W3AXL/MiniRIB-USB/README.md

# MiniRIB-USB
USB-based Motorola RIB

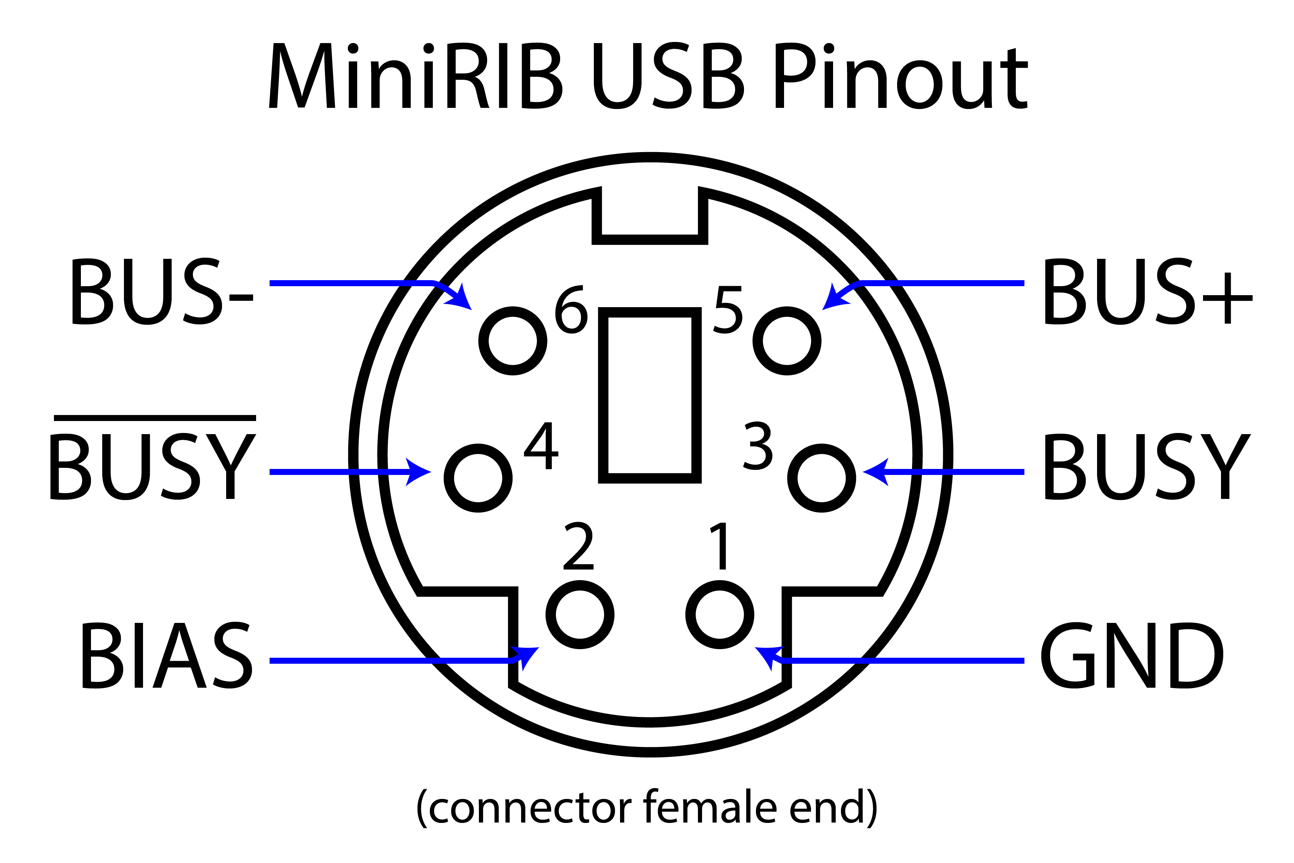
[picture p1: pinout.jpg]
pinout
