W3AXL/MiniRIB-USB/Full Assembly.step

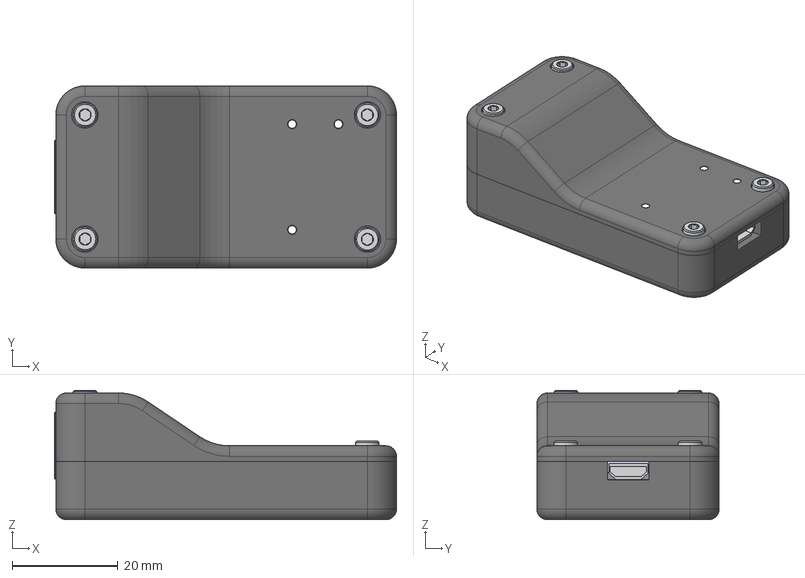
[picture p2: CAD file, 2023-05-07]
Full Assembly.step
64.8 x 34.5 x 24.5 mm
minirib-usb PCB
U254-051N-4BH83-F1B
91828A113_18-8 Stainless Steel Hex Nut x 4
Dialight 5151016F Light Pipe x 3
Case Top
91292A016_18-8 Stainless Steel Socket Head Screw x 2
91292A312_18-8 Stainless Steel Socket Head Screw x 2
Case Bottom
