W3AXL/MiniRIB-USB/minirib-usb-revE.step

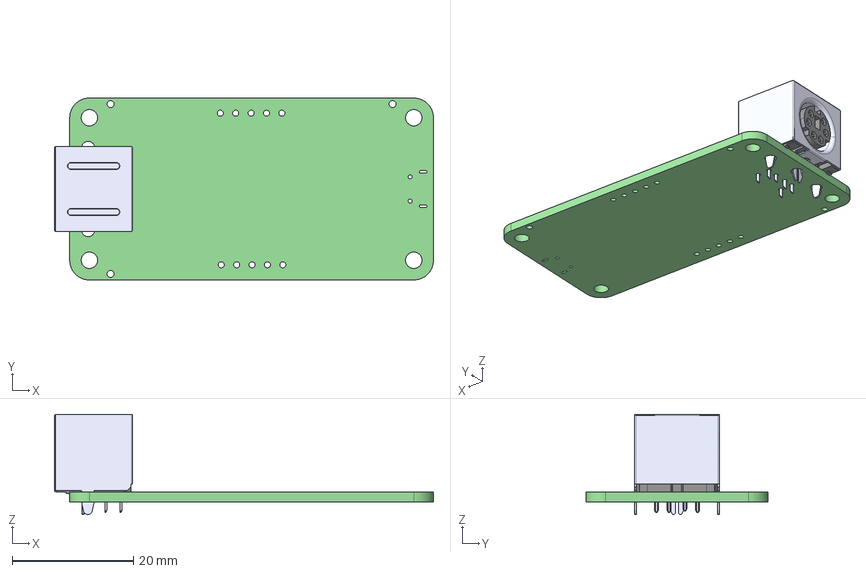
[picture p3: CAD file, 2023-05-07]
minirib-usb-revE.step
62.5 x 30.0 x 16.5 mm
minirib-usb PCB
