W3AXL/MiniRIB-USB/KMDGX-6S-BS_rC6.STEP

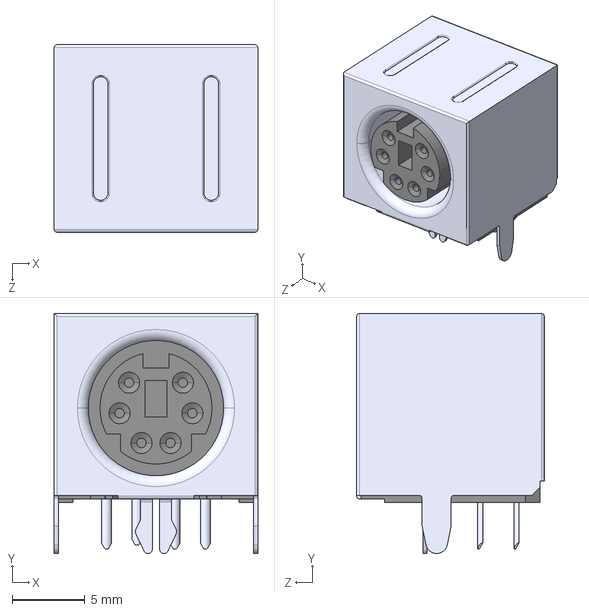
[picture p4: CAD file, 2021-12-10]
KMDGX-6S-BS_rC6.STEP
14.0 x 16.5 x 12.9 mm
