W3AXL/MiniRIB-USB/629105150521_Download_STP_629105150521_rev1.stp

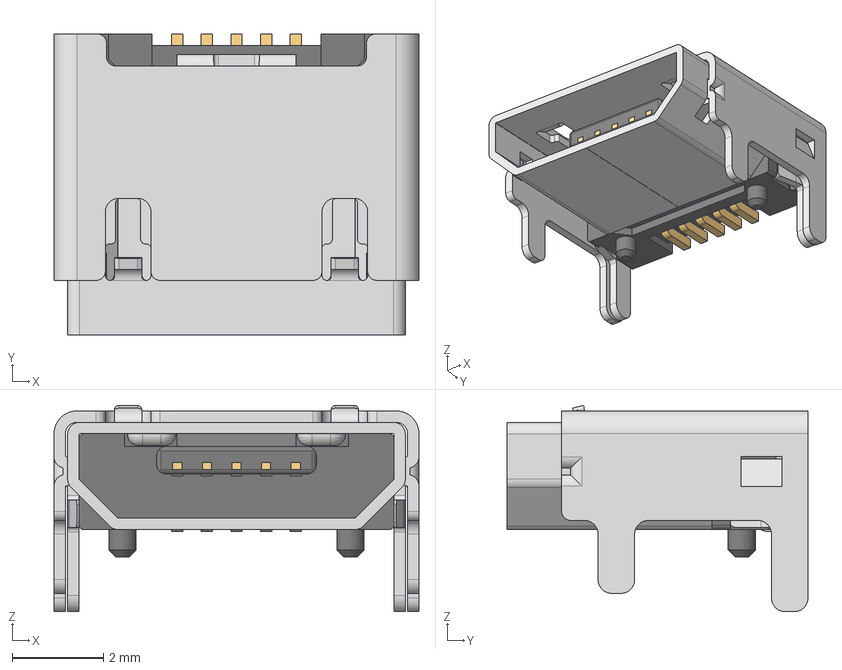
[picture p5: CAD file, 2021-12-10]
629105150521_Download_STP_629105150521_rev1.stp
8.00 x 6.60 x 4.52 mm
629105150521_Pin1 x 4
629105150521_Housing
629105150521_Pin2
629105150521_Shielding
629105150521_Shielding2
