W3AXL/MiniRIB-USB/sch/minirib-usb-revE.pdf

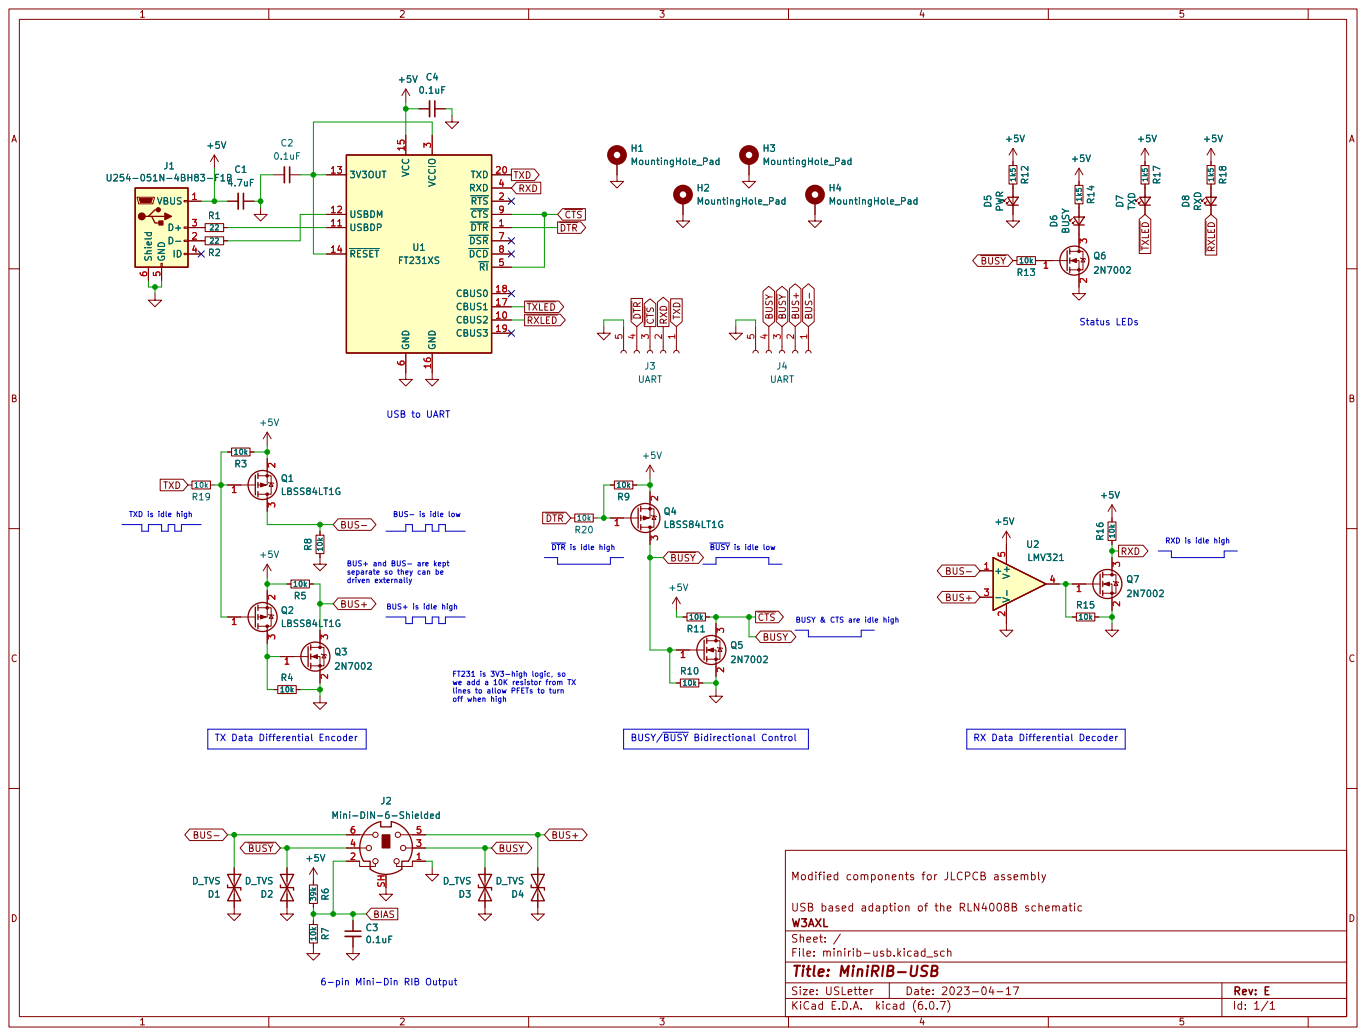
[picture p6: page 1]

RXD is idle high Status LEDs

~{BUSY} is idle low

FT231 is 3V3-high logic, so we add a 10K resistor from TX

Modified components for JLCPCB assembly

File: minirib-usb.kicad_sch Sheet: / W3AXL USB based adaption of the RLN4008B schematic

Id: 1/1 Title: MiniRIB-USB
