W3AXL/MiniRIB-USB/sch/minirib-usb-revD.pdf

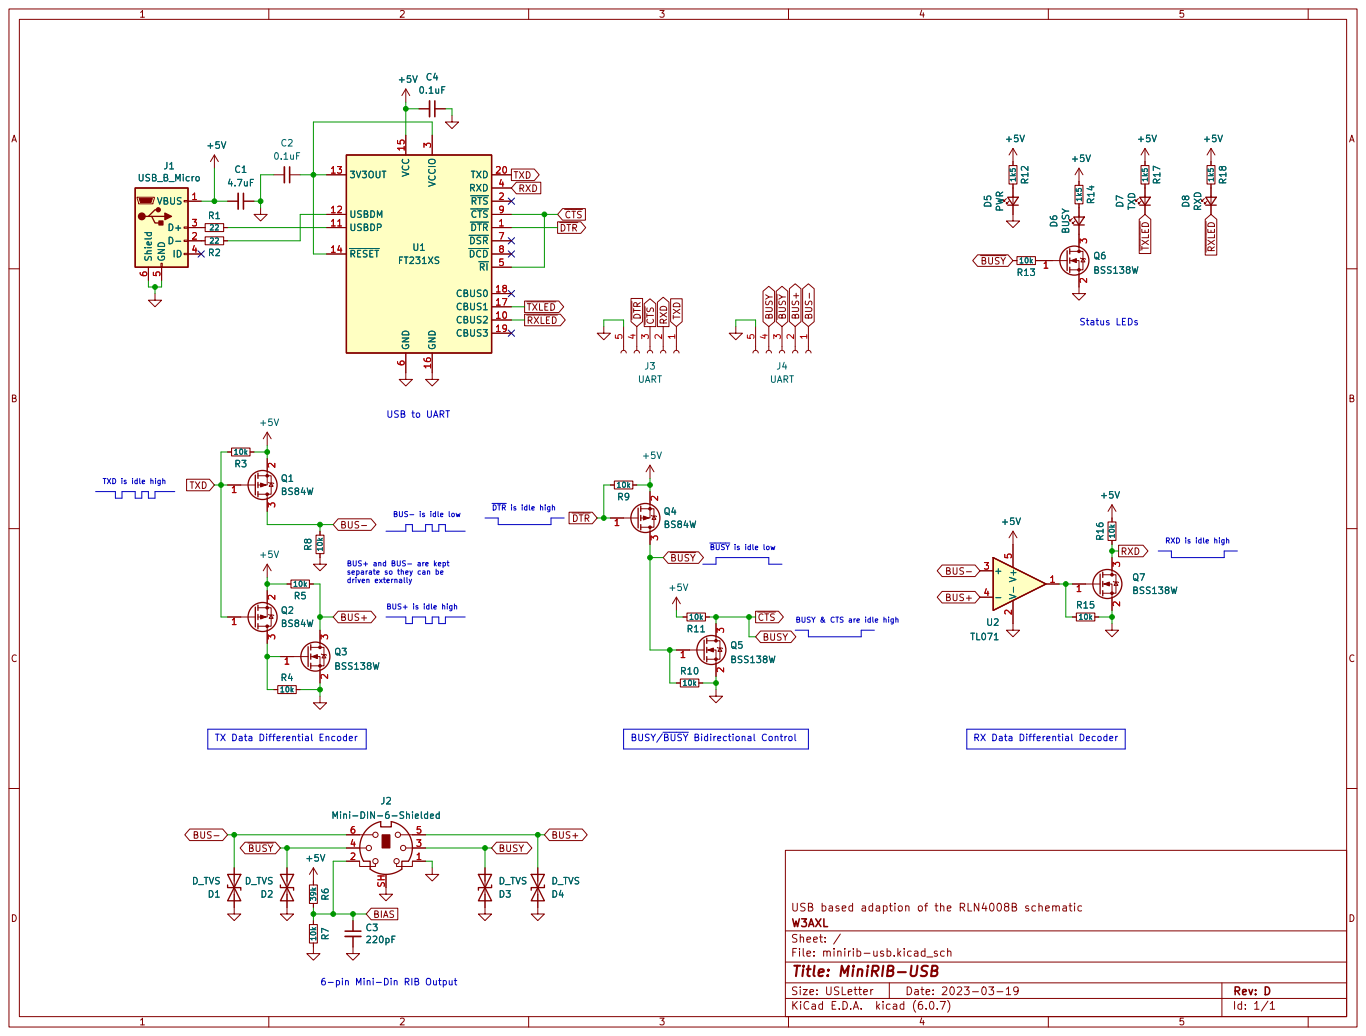
[picture p7: page 1]

2 3 Q7BSS138W R16 10k +5V ~{BUSY} BIAS BUS+ BUS-

Id: 1/1 Title: MiniRIB-USB
