W3AXL/MiniRIB-USB/sim/mosfet-datalines.asc

M1: pmos; BSS84
M2: pmos; BSS84
M3: nmos; 2N7002
M4: nmos; 2N7002
M5: pmos; BSS84
M6: nmos; 2N7002
M7: pmos; BSS84
M8: nmos; 2N7002
M9: nmos; 2N7002
M10: pmos; BSS84
R1: res; 10k
R2: res; 10k
R3: res; 10k
R4: res; 10k
R5: res; 10k
R6: res; 10k
R7: res; 10k
R8: res; 10k
R9: res; 10k
R10: res; 10k
R11: res; 10k
R12: res; 10k
R13: res; 10k
R14: res; 10k
R15: res; 10k
U1: UniversalOpamp2; Avol=100k GBW=1Meg Slew=1Meg; Ilimit=25m Rail=0 Vos=1m
V1: voltage; 5
V2: voltage; PULSE(3.3 0 100u 1u 1u 50u 100u 8)
V3: voltage; PULSE(5 0 1100u 1u 1u 50u 100u 8)
V4: voltage; PULSE(3.3 0 75u 1u 1u 850u 1000u 1)
V5: voltage; PULSE(0 5 1075u 1u 1u 850u 1000u 1)
Named nets: 0, 5V, TXD1, BUS-, BUS+, RXD, DATA2, DTR1, /BUSY2, /BUSY, CTS, BUSY, /DATA2, BUSY2
.tran 2m
