W3AXL/MiniRIB-USB/sim/rx-sim.asc

Q1: npn; 2N3904
Q2: pnp
R1: res; 20k
R2: res; 9k
R3: res; 1.5k
R4: res; 9k
U1: ADTL082
V1: voltage; 5
V2: voltage; PULSE(5 0 0.001 0 0 0.001 0.002)
V3: voltage; PULSE(0 5 0.001 0 0 0.001 0.002)
V4: voltage; 8
V5: voltage; -8
Named nets: 0, 5V, BUS-, BUS+, RXD, 8V, -8V
.tran 0.01
