W3AXL/MiniRIB-USB/sim/busy.asc

Q1: pnp; 2N3906
Q2: npn; 2N3904
R1: res; 4.7k
R2: res; 4.7k
R3: res; 4.7k
V1: voltage; 5
V2: voltage; PULSE(5 0 4u 0 0 4u 8u)
Named nets: 0, 5V, /BUSY, /DTR, /CTS, BUSY
.tran 50u
