W3AXL/MiniRIB-USB/minirib-usb.kicad_pcb

## KiCad design minirib-usb.kicad_pcb (2023-05-07)

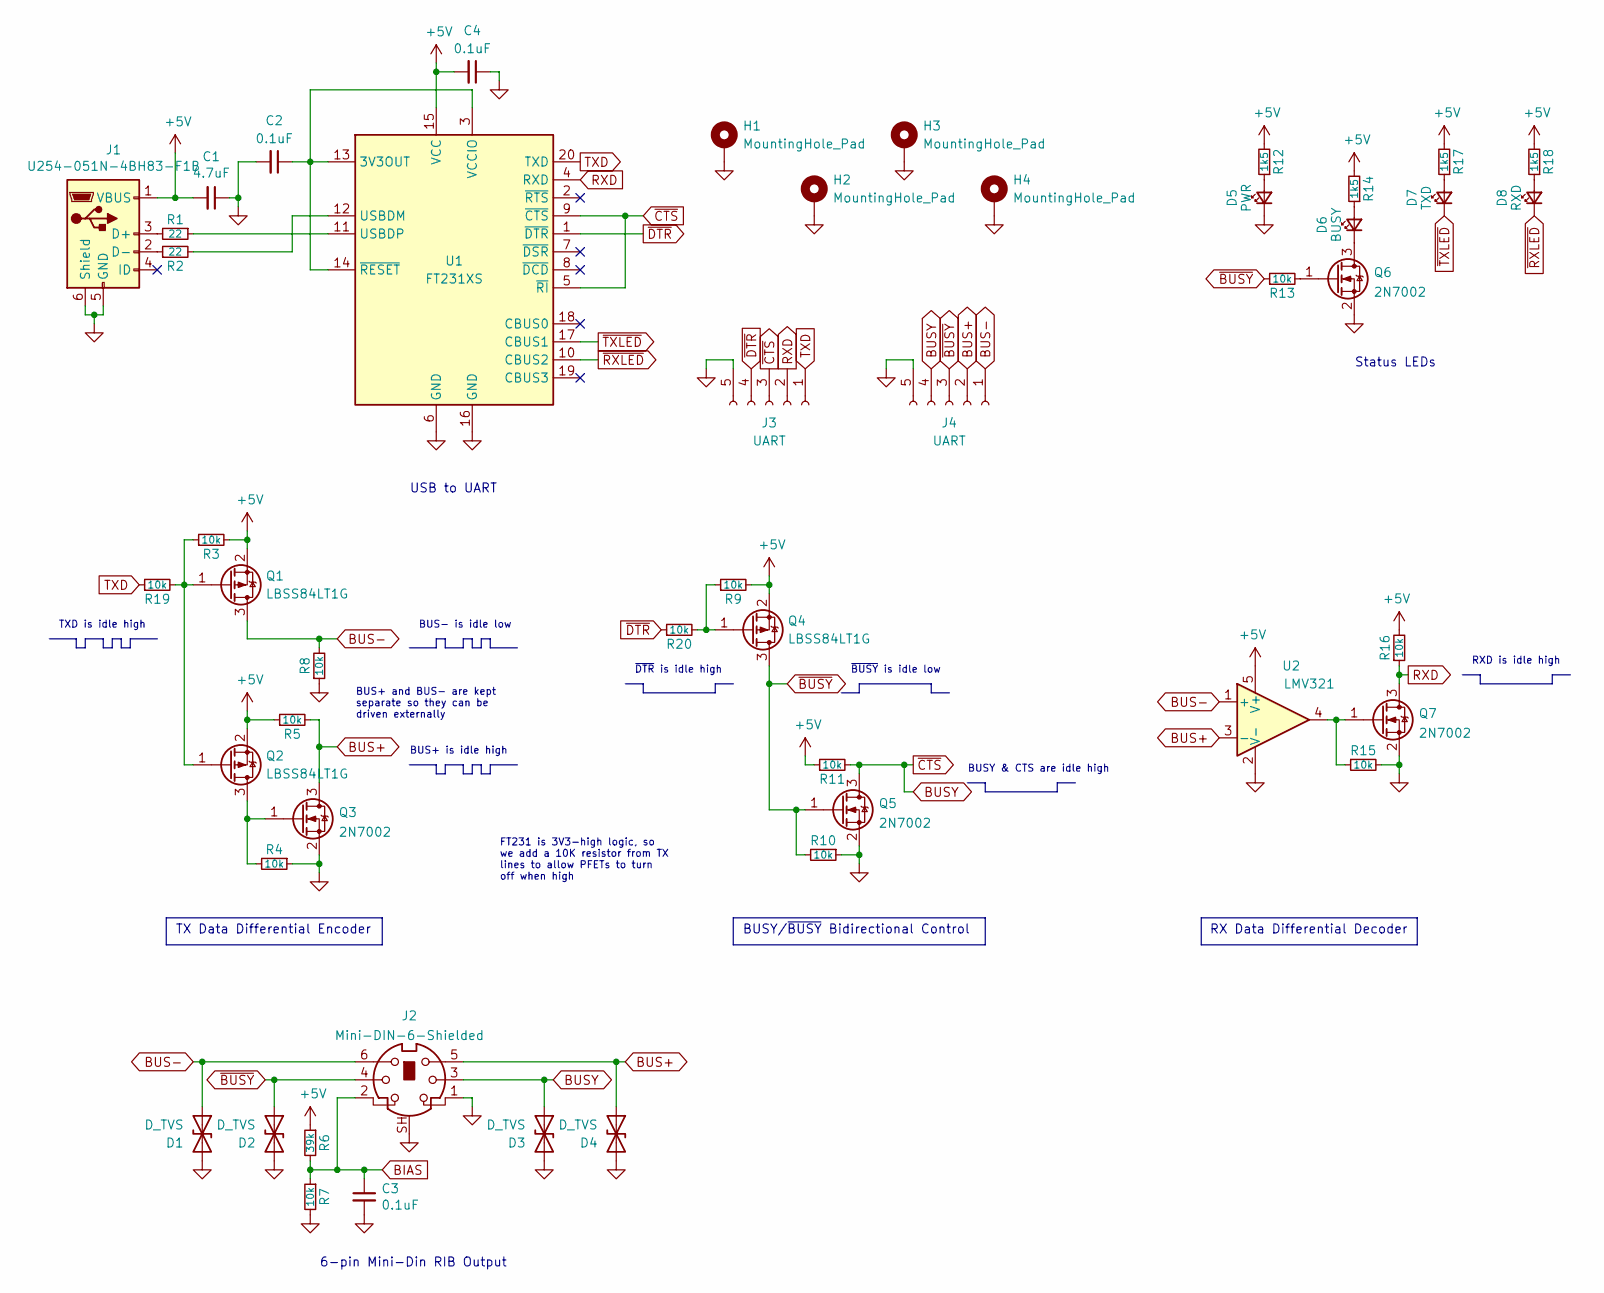
[picture p8: schematic minirib-usb.kicad_sch]

Parts:
C1: 4.7uF; C_0805_2012Metric_Pad1.18x1.45mm_HandSolder; LCSC C1779
C2, C3, C4: 0.1uF; C_0805_2012Metric_Pad1.18x1.45mm_HandSolder; LCSC C49678
D1, D2, D3, D4: D_TVS; D_SOD-123F; LCSC C2990473
D5: PWR; D_0805_2012Metric_Pad1.15x1.40mm_HandSolder; LCSC C434433
D6: BUSY; D_0805_2012Metric_Pad1.15x1.40mm_HandSolder; LCSC C2296
D7: TXD; D_0805_2012Metric_Pad1.15x1.40mm_HandSolder; LCSC C84256
D8: RXD; D_0805_2012Metric_Pad1.15x1.40mm_HandSolder; LCSC C434435
H1, H2, H3, H4: MountingHole_Pad; MountingHole_2.7mm_M2.5_Pad_TopBottom
J1: U254-051N-4BH83-F1B; LCSC C319169
J2: Mini-DIN-6-Shielded; KMDGX-6S-BS
J3, J4: UART; PinHeader_1x05_P2.54mm_Vertical
Q1, Q2, Q4: LBSS84LT1G; SOT-23_Handsoldering; LCSC C8492
Q3, Q5, Q6, Q7: 2N7002; SOT-23_Handsoldering; LCSC C8545
R1, R2: 22; R_0805_2012Metric_Pad1.20x1.40mm_HandSolder
R3, R4, R5, R7, R8, R9, R10, R11, R13, R15, R16, R19, R20: 10k; R_0805_2012Metric_Pad1.20x1.40mm_HandSolder; LCSC C17414
R6: 39k; R_0805_2012Metric_Pad1.20x1.40mm_HandSolder; LCSC C25826
R12, R14, R17, R18: 1k5; R_0805_2012Metric_Pad1.20x1.40mm_HandSolder; LCSC C4310
U1: FT231XS; SSOP-20_3.9x8.7mm_P0.635mm; LCSC C132160
U2: LMV321; SOT-23-5_HandSoldering; LCSC C7972

Connections:
+5V: C1.2, C4.2, J1.1 (VBUS), Q1.2 (S), Q2.2 (S), Q4.2 (S), R3.2, R5.1, R6.1, R9.2, R11.1, R12.2, R14.2, R16.2, R17.2, R18.2, U1.15 (VCC), U2.5 (V+)
BIAS: C3.1, J2.2, R6.2, R7.1
BUS+: D4.1 (A1), J2.5, J4.2, Q3.3 (D), R5.2, U2.3 (-)
BUS-: D1.1 (A1), J2.6, J4.1, Q1.3 (D), R8.2, U2.1 (+)
BUSY: D3.1 (A1), J2.3, J3.3, J4.4, Q5.3 (D), R11.2, U1.5 (~RI), U1.9 (~CTS)
GND: C1.1, C2.2, C3.2, C4.1, D1.2 (A2), D2.2 (A2), D3.2 (A2), D4.2 (A2), D5.1 (K), H1.1, H2.1, H3.1, H4.1, J1.5 (GND), J1.6 (Shield), J2.1, J2.SH, J3.5, J4.5, Q3.2 (S), Q5.2 (S), Q6.2 (S), Q7.2 (S), R4.1, R7.2, R8.1, R10.1, R15.2, U1.6 (GND), U1.16 (GND), U2.2 (V-)
unnamed: C2.1, U1.3 (VCCIO), U1.13 (3V3OUT), U1.14 (~RESET)
unnamed: D5.2 (A), R12.1
unnamed: D6.1 (K), Q6.3 (D)
unnamed: D6.2 (A), R14.1
unnamed: D7.2 (A), R17.1
unnamed: D8.2 (A), R18.1
unnamed: J1.2 (D-), R2.1
unnamed: J1.3 (D+), R1.2
unnamed: Q1.1 (G), Q2.1 (G), R3.1, R19.2
unnamed: Q2.3 (D), Q3.1 (G), R4.2
unnamed: Q4.1 (G), R9.1, R20.2
unnamed: Q6.1 (G), R13.2
unnamed: Q7.1 (G), R15.1, U2.4
unnamed: R1.1, U1.11 (USBDP)
unnamed: R2.2, U1.12 (USBDM)
RXD: J3.2, Q7.3 (D), R16.1, U1.4 (RXD)
TXD: J3.1, R19.1, U1.20 (TXD)
~BUSY: D2.1 (A1), J2.4, J4.3, Q4.3 (D), Q5.1 (G), R10.2, R13.1
~DTR: J3.4, R20.1, U1.1 (~DTR)
~RXLED: D8.1 (K), U1.10 (CBUS2)
~TXLED: D7.1 (K), U1.17 (CBUS1)

Notes on the sheet:
Status LEDs
FT231 is 3V3-high logic, so we add a 10K resistor from TX lines to allow PFETs to turn off when high
BUS- is idle low
TX Data Differential Encoder
BUSY & CTS are idle high
RX Data Differential Decoder
~{BUSY} is idle low
6-pin Mini-Din RIB Output
~{DTR} is idle high
BUSY/~{BUSY} Bidirectional Control
RXD is idle high
TXD is idle high
USB to UART
BUS+ is idle high
BUS+ and BUS- are kept separate so they can be driven externally

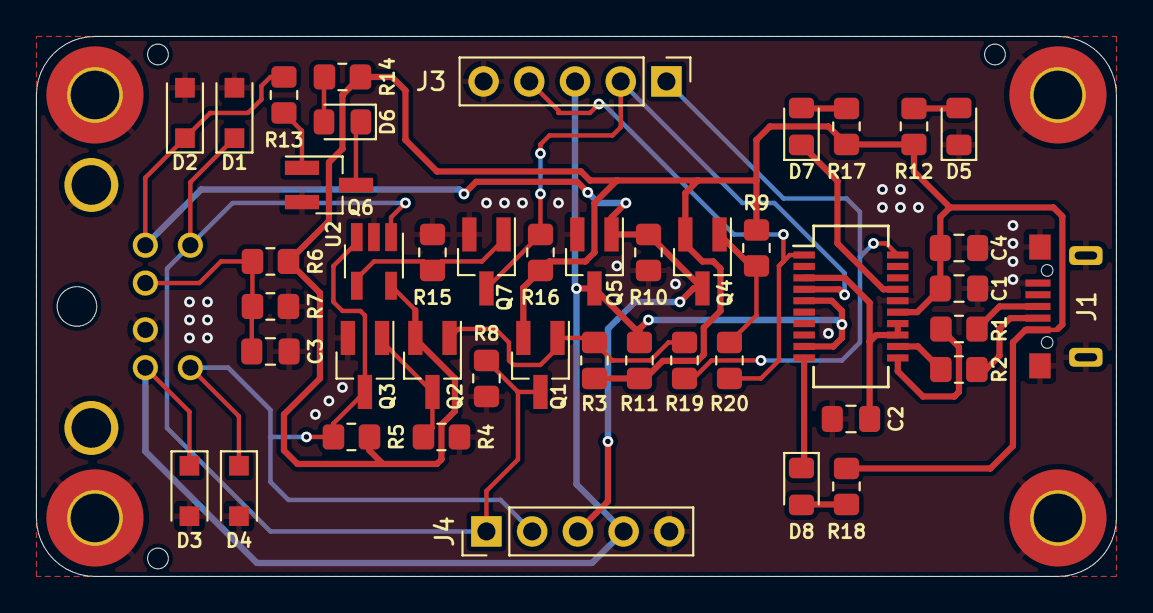
[picture p9: board minirib-usb.kicad_pcb from above]

Board: 2 copper layers, 60.0 x 30.0 mm, 52 parts (0 on the bottom side), 27 nets.

Other parts of the board:
th1, th2, th3: tooling-hole
