W3AXL/MiniRIB-USB/(commit log)

2021-07-26 initial schematic work
    [minirib-usb.kicad_pcb, minirib-usb.sch]
2021-08-07 added test connector
    [minirib-usb.sch]
2021-08-07 schematic rework
    more closely following the original RIB schematic
    [minirib-usb.sch]
2021-09-13 updated schematic with test headers and cleaned up
    [minirib-usb.sch]
2021-09-14 finalized initial schematic work
    [minirib-usb.sch]
2021-12-09 more work on schematic and PCB
    [minirib-usb.kicad_pcb, minirib-usb.sch]
2021-12-10 Finalized rev A schematic and PCB
    [629105150521_Download_STP_629105150521_rev1.stp, KMDGX-6S-BS_rC6.STEP, minirib-usb.kicad_pcb, minirib-usb.sch]
2021-12-10 extra schematic work
    [minirib-usb.sch]
2021-12-11 finalized schematic for real this time
    [minirib-usb.kicad_pcb, minirib-usb.sch]
2021-12-11 generated gerbers
    [minirib-usb-B_Cu.gbr, minirib-usb-B_Mask.gbr, minirib-usb-B_Paste.gbr, minirib-usb-B_SilkS.gbr, minirib-usb-Edge_Cuts.gbr, minirib-usb-F_Cu.gbr, minirib-usb-F_Mask.gbr, minirib-usb-F_Paste.gbr]
2022-01-04 converted to Kicad 6 project
    [minirib-usb.kicad_pcb, minirib-usb.kicad_sch, minirib-usb.sch]
2022-01-04 finalized schematic for rev B
    switched to CH340G for USB to serial operations due to supply chain issues with FTDI, and re-worked BUS- and /BUSY transistor arrangements to work properly without +15V RS232 as found in original schematic
    [minirib-usb.kicad_sch]
2022-01-04 started work on PCB, added LTSpice sims for circuit
    [minirib-usb.kicad_pcb]
2022-01-04 finalized PCB & schematic for rev B
    [minirib-usb.kicad_pcb, minirib-usb.kicad_sch]
2022-01-04 switched to SC70 package for TL081
    [minirib-usb.kicad_pcb, minirib-usb.kicad_sch]
2022-01-04 added new BOM for rev B and cleaned up kicad v5 files
    [minirib-usb.sch, minirib-usb_BOM.csv]
2022-01-04 updated gerbers and new schematic pdf
    [minirib-usb-B_Cu.gbr, minirib-usb-B_Mask.gbr, minirib-usb-B_Paste.gbr, minirib-usb-B_Silkscreen.gbr, minirib-usb-Edge_Cuts.gbr, minirib-usb-F_Cu.gbr, minirib-usb-F_Mask.gbr, minirib-usb-F_Paste.gbr]
2022-01-04 small PCB cleanup
    fixed PCB text and added logo
    [minirib-usb-B_Cu.gbr, minirib-usb-B_Mask.gbr, minirib-usb-B_Paste.gbr, minirib-usb-B_Silkscreen.gbr, minirib-usb-Edge_Cuts.gbr, minirib-usb-F_Cu.gbr, minirib-usb-F_Mask.gbr, minirib-usb-F_Paste.gbr]
2022-01-04 added drill files to gerbers
    [minirib-usb-B_Cu.gbr, minirib-usb-B_Mask.gbr, minirib-usb-B_Paste.gbr, minirib-usb-B_Silkscreen.gbr, minirib-usb-Edge_Cuts.gbr, minirib-usb-F_Cu.gbr, minirib-usb-F_Mask.gbr, minirib-usb-F_Paste.gbr]
2022-01-04 added correct capacitors for crystal
    [minirib-usb.kicad_sch, minirib-usb_BOM.csv]
2022-01-21 schematic fixes based on rev B testing
    - switched Opamp to MCP6491T to use correct footprint (SC70 footprint for TL081H is incorrect)
    - Removed D7 BUSY LED as it was interfering with the proper signalling on the BUSY line
    [minirib-usb-B_Cu.gbr, minirib-usb-B_Mask.gbr, minirib-usb-B_Paste.gbr, minirib-usb-B_Silkscreen.gbr, minirib-usb-Edge_Cuts.gbr, minirib-usb-F_Cu.gbr, minirib-usb-F_Mask.gbr, minirib-usb-F_Paste.gbr]
2022-01-28 Update RIB Signals.txt
    Clarified RIB signals based on observation of real RIB behavior. Realized that UART TX/RX is active high while RS232 is active low. Will need to rework schematic & pcb
2022-05-05 rev C total redesign
    Changed circuit to use an FT231 + MAX232 usb chain, with original transistor logic conversion identical to the RLN4008B schematic to ensure proper operation
    [minirib-usb.kicad_sch]
2022-10-10 finalized schematic and pcb
    [minirib-usb.kicad_pcb, minirib-usb.kicad_sch]
2022-10-12 generated schematic and gerbers for rev C PCB
    [minirib-usb-B_Cu.gbr, minirib-usb-B_Mask.gbr, minirib-usb-B_Paste.gbr, minirib-usb-B_Silkscreen.gbr, minirib-usb-Edge_Cuts.gbr, minirib-usb-F_Cu.gbr, minirib-usb-F_Mask.gbr, minirib-usb-F_Paste.gbr]
2023-03-29 initial revision D updates
    [minirib-usb-B_Cu.gbr, minirib-usb-B_Mask.gbr, minirib-usb-B_Paste.gbr, minirib-usb-B_Silkscreen.gbr, minirib-usb-Edge_Cuts.gbr, minirib-usb-F_Cu.gbr, minirib-usb-F_Mask.gbr, minirib-usb-F_Paste.gbr]
2023-04-03 finalizing rev D
    [minirib-usb-B_Cu.gbr, minirib-usb-B_Mask.gbr, minirib-usb-B_Paste.gbr, minirib-usb-B_Silkscreen.gbr, minirib-usb-Edge_Cuts.gbr, minirib-usb-F_Cu.gbr, minirib-usb-F_Mask.gbr, minirib-usb-F_Paste.gbr]
2023-04-12 revision E updates
    added 10k resistors to TX & DTR lines from FT231XS to allow PFETs to turn off properly when TX/DTR at 3V3. Currently they're always on (oops)
    [minirib-usb-BOM-revD.csv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]
2023-04-18 PCB assembly updates
    updates to revision E to add LCSC components to allow for JLCPCB manufacture
    [minirib-usb-B_Cu.gbr, minirib-usb-B_Mask.gbr, minirib-usb-B_Paste.gbr, minirib-usb-B_Silkscreen.gbr, minirib-usb-Edge_Cuts.gbr, minirib-usb-F_Cu.gbr, minirib-usb-F_Mask.gbr, minirib-usb-F_Paste.gbr]
2023-05-07 finalized schematic and layout for production
    [Full Assembly.step, minirib-usb-revE.step, minirib-usb.kicad_pcb]
2023-07-25 removed unneeded gerbers
    [minirib-usb-B_Cu.gbr, minirib-usb-B_Mask.gbr, minirib-usb-B_Paste.gbr, minirib-usb-B_SilkS.gbr, minirib-usb-B_Silkscreen.gbr, minirib-usb-Edge_Cuts.gbr, minirib-usb-F_Cu.gbr, minirib-usb-F_Mask.gbr]
2023-07-25 updated gitignore
    [minirib-usb-BOM-revD.csv, minirib-usb-bom-revC.csv, minirib-usb-revE-jlcpcb.csv, minirib-usb_BOM.csv]
